SAMIARSLAN-NKU/EnergyMe-Open-Source-Smart-Energy-Meter/README.md

# EnergyMe-Open-Source-Smart-Energy-Meter
Open-source multi-channel smart energy meter platform based on ESP32-S3 and ADE7953, featuring 17-channel monitoring, circuit-level calibration, REST API, MQTT, InfluxDB, local data logging, and OTA support.
