SAMIARSLAN-NKU/EnergyMe-Open-Source-Smart-Energy-Meter/hardware/images/back.jpg

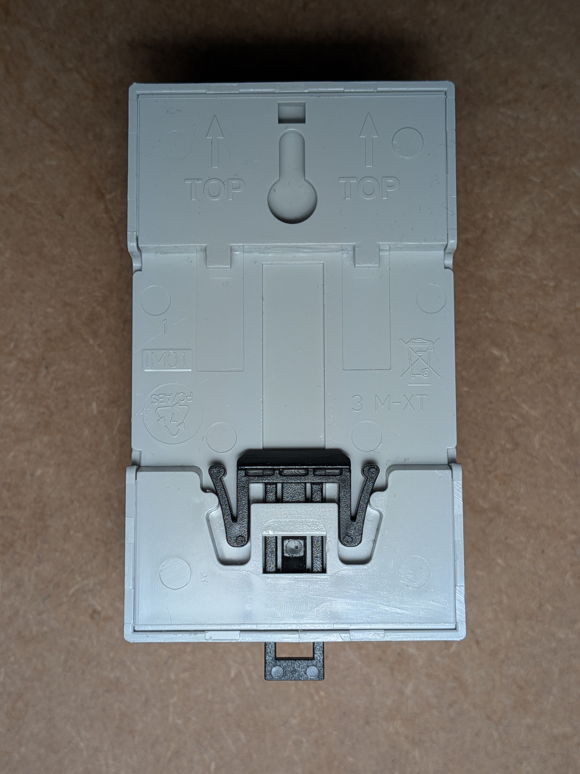
hardware/images/back.jpg
