SAMIARSLAN-NKU/EnergyMe-Open-Source-Smart-Energy-Meter/hardware/images/bottom.jpg

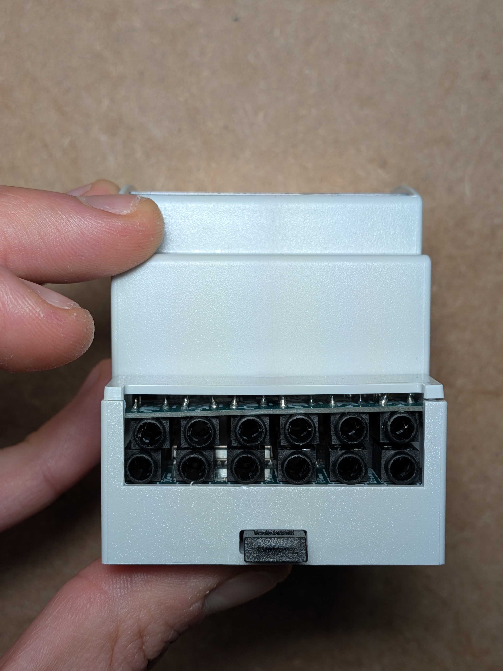
hardware/images/bottom.jpg
