SAMIARSLAN-NKU/EnergyMe-Open-Source-Smart-Energy-Meter/hardware/images/bottom_bare.jpg

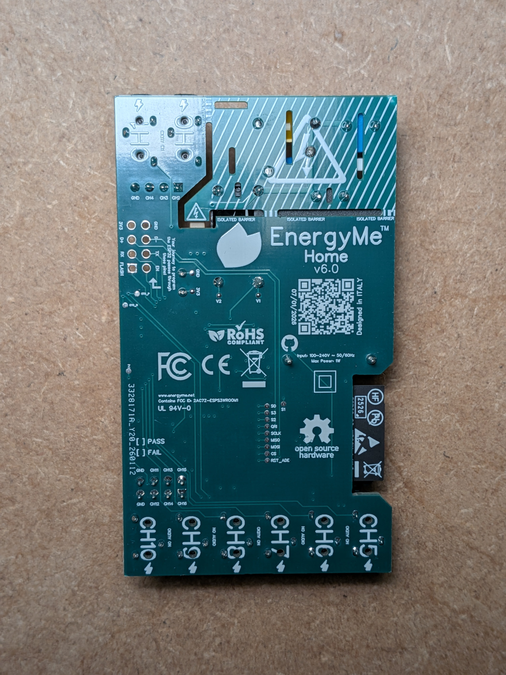
hardware/images/bottom_bare.jpg
