SAMIARSLAN-NKU/EnergyMe-Open-Source-Smart-Energy-Meter/hardware/images/ct.jpg

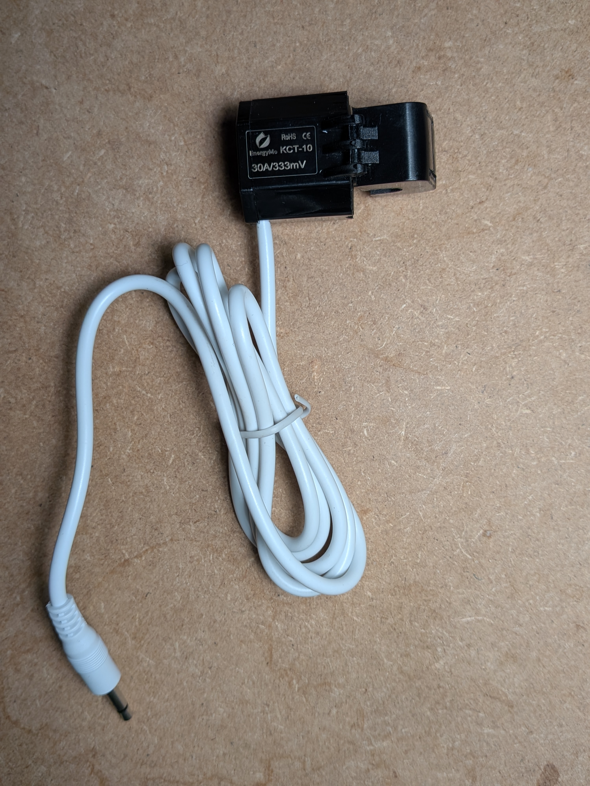
hardware/images/ct.jpg
