SAMIARSLAN-NKU/EnergyMe-Open-Source-Smart-Energy-Meter/hardware/images/front.jpg

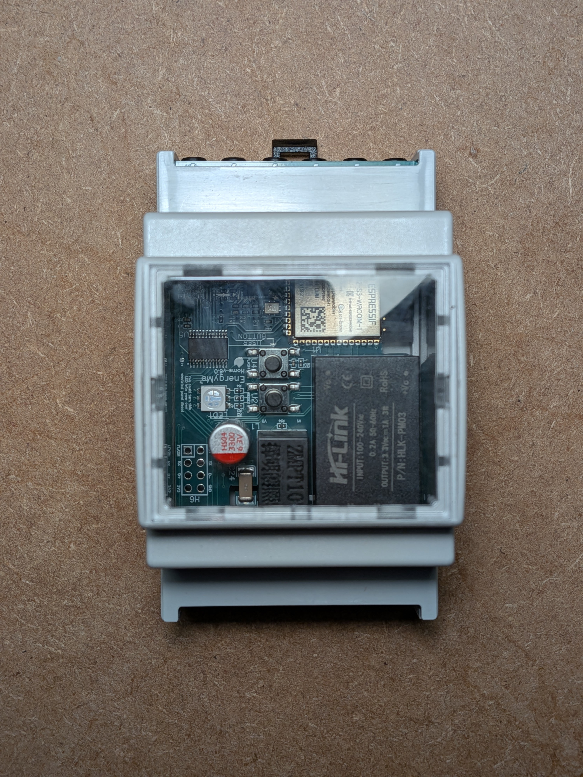
hardware/images/front.jpg
