SAMIARSLAN-NKU/EnergyMe-Open-Source-Smart-Energy-Meter/hardware/images/top_bare.jpg

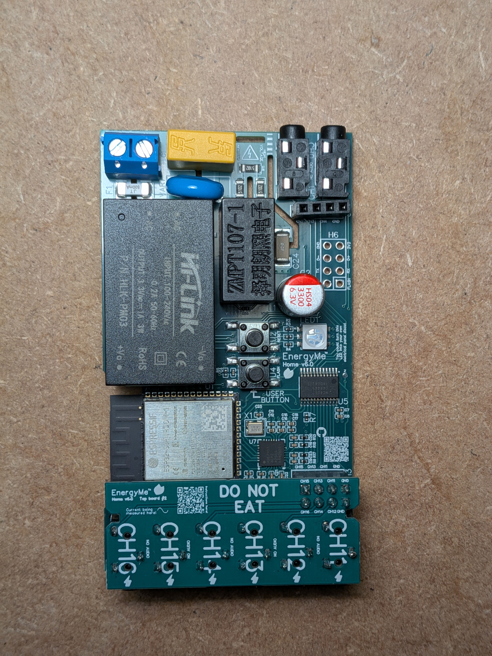
hardware/images/top_bare.jpg
