SAMIARSLAN-NKU/EnergyMe-Open-Source-Smart-Energy-Meter/hardware/images/top_with_ct.jpg

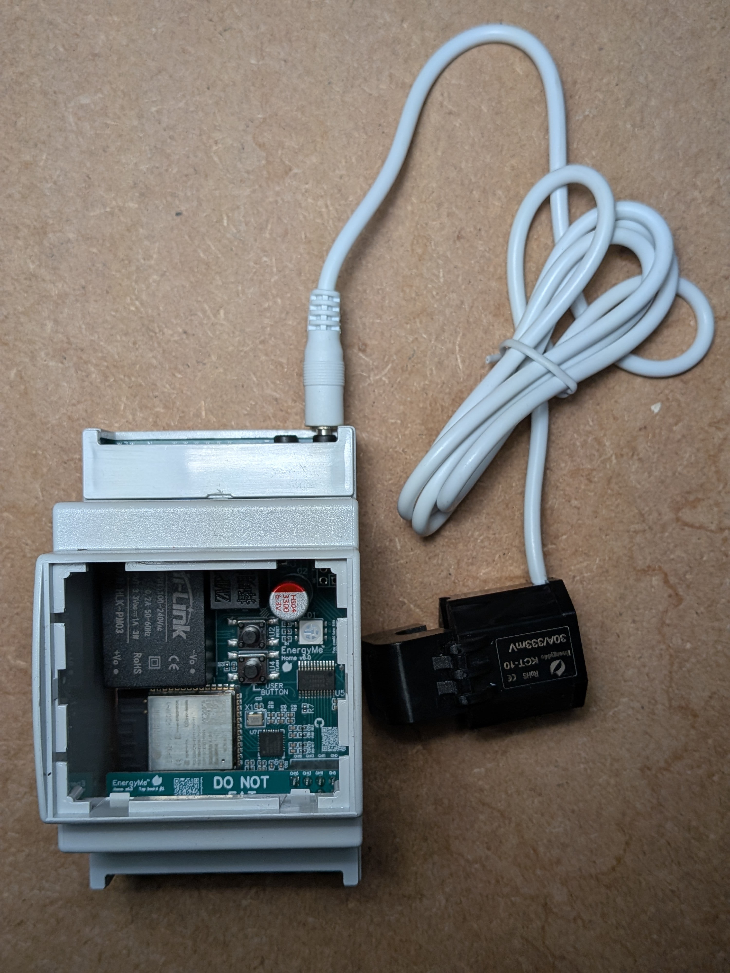
hardware/images/top_with_ct.jpg
