SAMIARSLAN-NKU/EnergyMe-Open-Source-Smart-Energy-Meter/hardware/pcb/main_board/3d_view_top.png

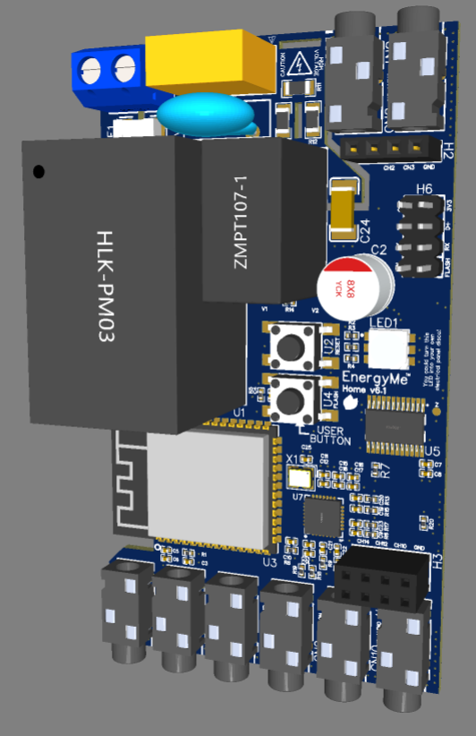
hardware/pcb/main_board/3d_view_top.png
