SAMIARSLAN-NKU/EnergyMe-Open-Source-Smart-Energy-Meter/hardware/pcb/main_board/pcb_bottom.png

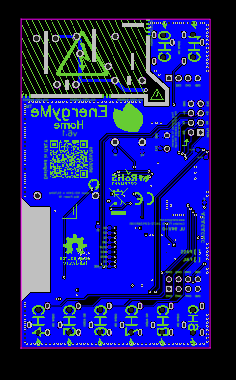
hardware/pcb/main_board/pcb_bottom.png
