SAMIARSLAN-NKU/EnergyMe-Open-Source-Smart-Energy-Meter/hardware/pcb/main_board/pcb_top.png

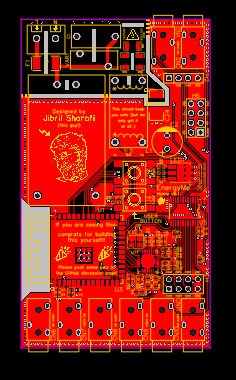
hardware/pcb/main_board/pcb_top.png
