SAMIARSLAN-NKU/EnergyMe-Open-Source-Smart-Energy-Meter/hardware/pcb/schematics_page_2.png

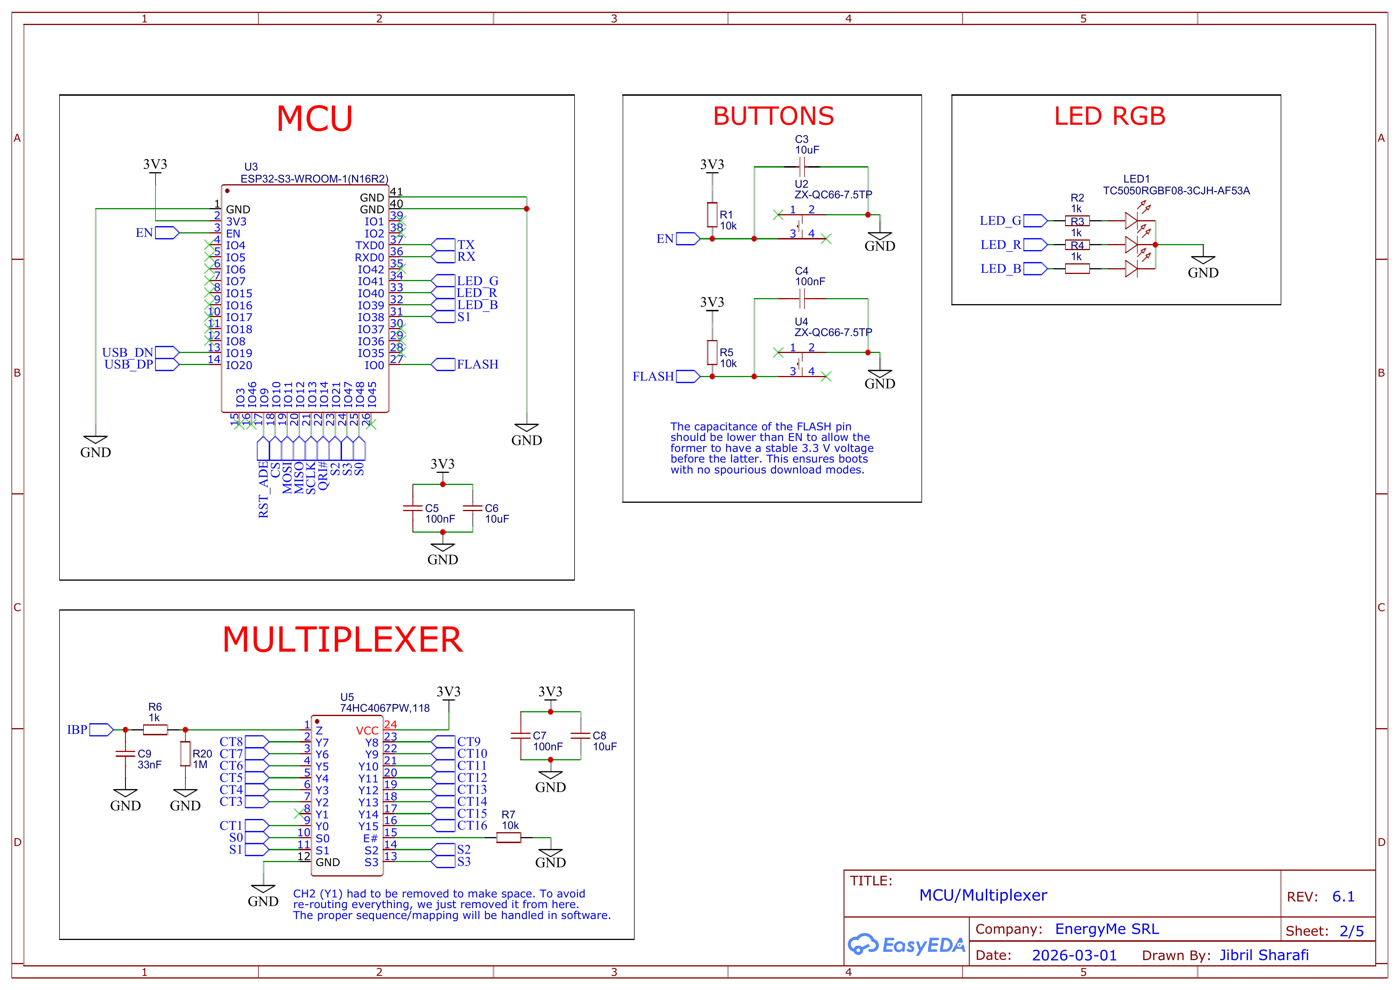
hardware/pcb/schematics_page_2.png
