SAMIARSLAN-NKU/EnergyMe-Open-Source-Smart-Energy-Meter/hardware/pcb/schematics_page_5.png

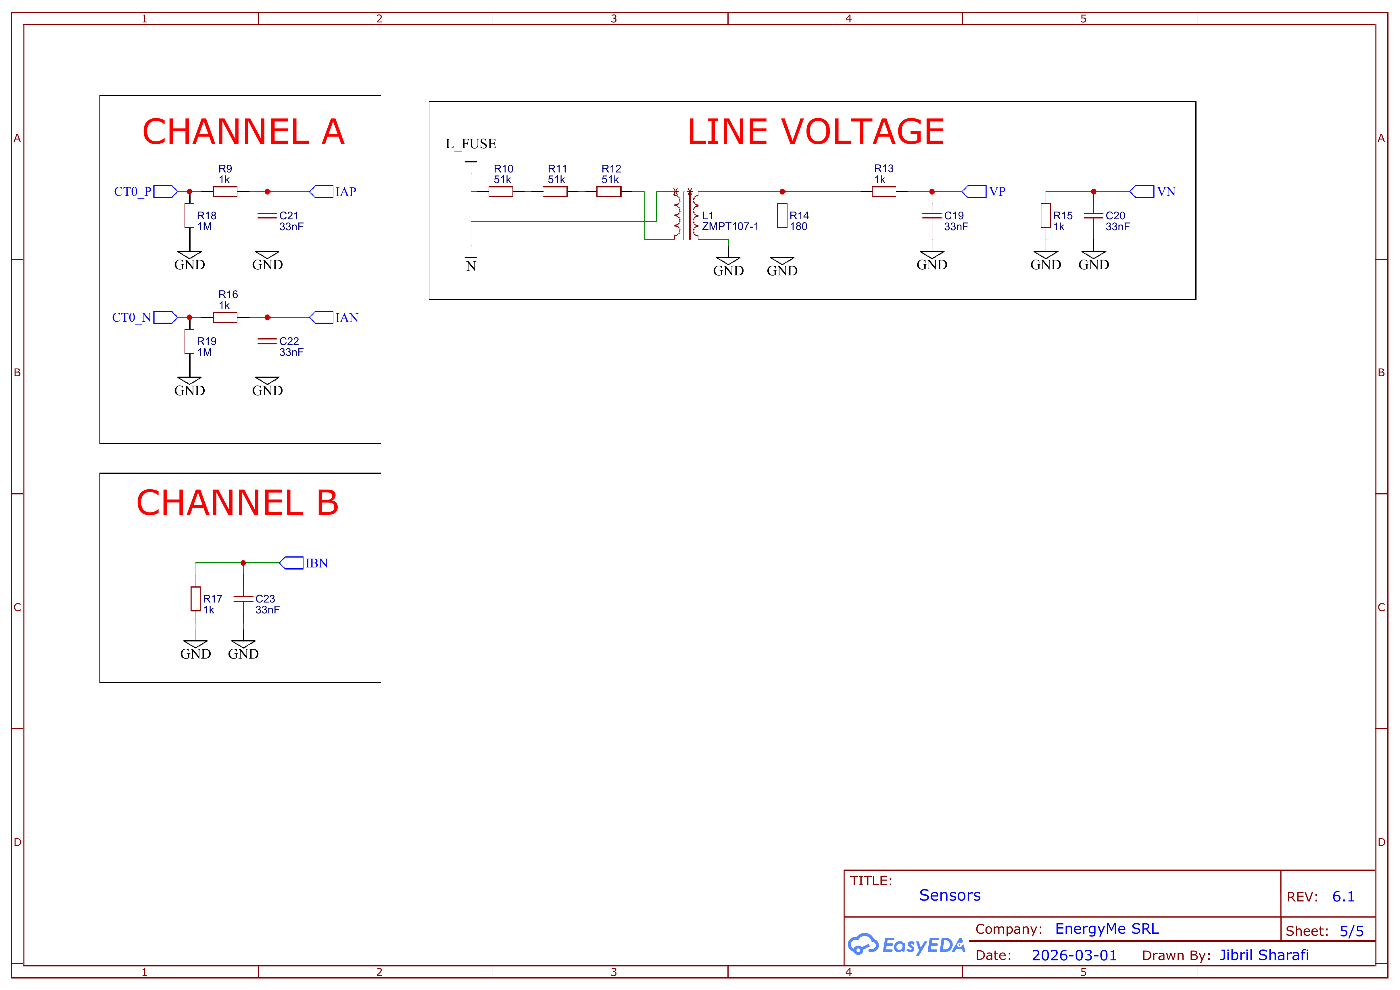
hardware/pcb/schematics_page_5.png
