SAMIARSLAN-NKU/EnergyMe-Open-Source-Smart-Energy-Meter/hardware/pcb/top_board_1/3d_view_bottom.png

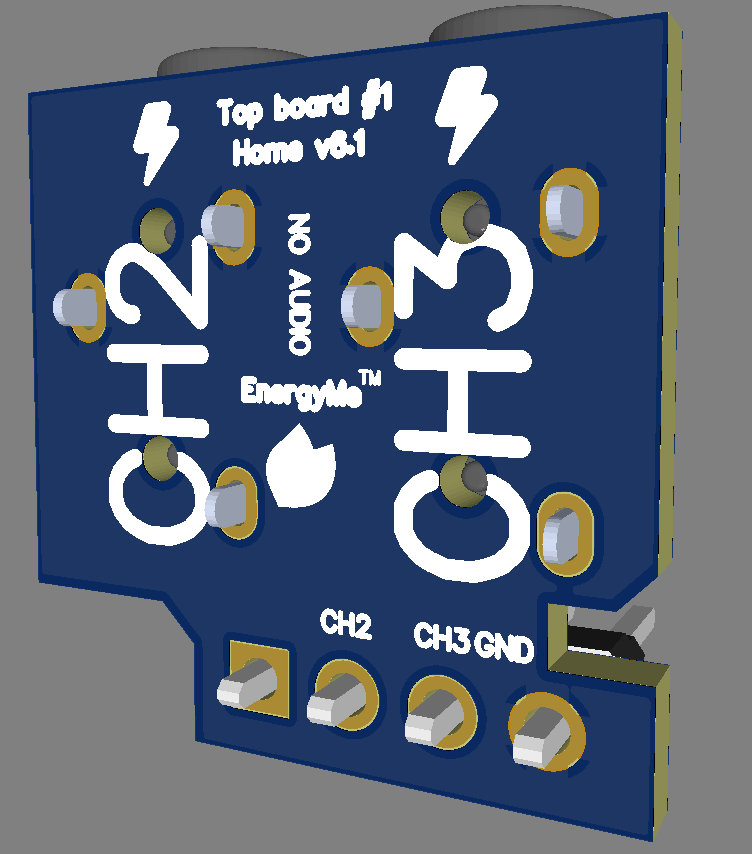
hardware/pcb/top_board_1/3d_view_bottom.png
