SAMIARSLAN-NKU/EnergyMe-Open-Source-Smart-Energy-Meter/hardware/pcb/top_board_1/3d_view_top.png

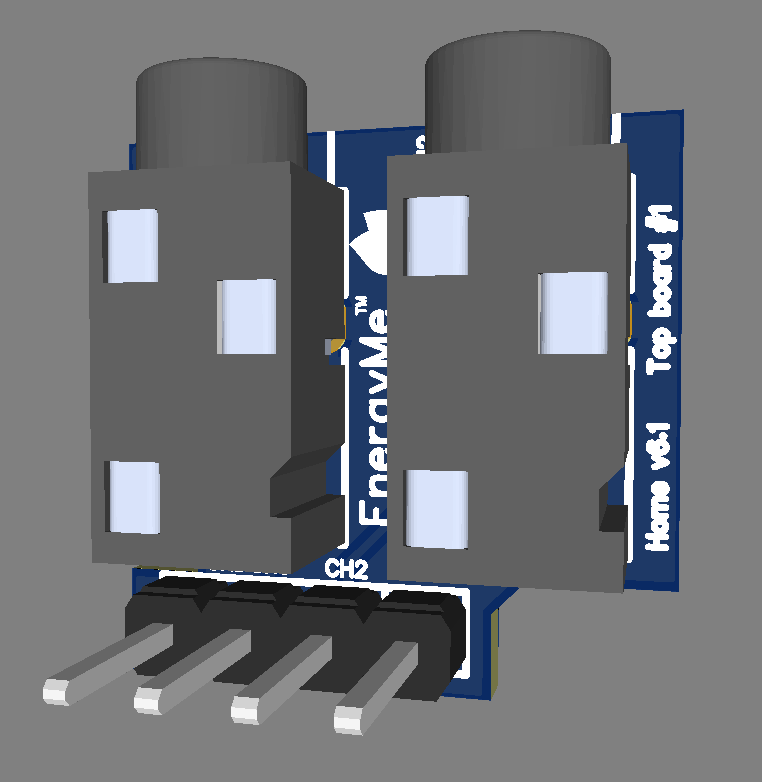
hardware/pcb/top_board_1/3d_view_top.png
