SAMIARSLAN-NKU/EnergyMe-Open-Source-Smart-Energy-Meter/hardware/pcb/top_board_2/3d_view_bottom.png

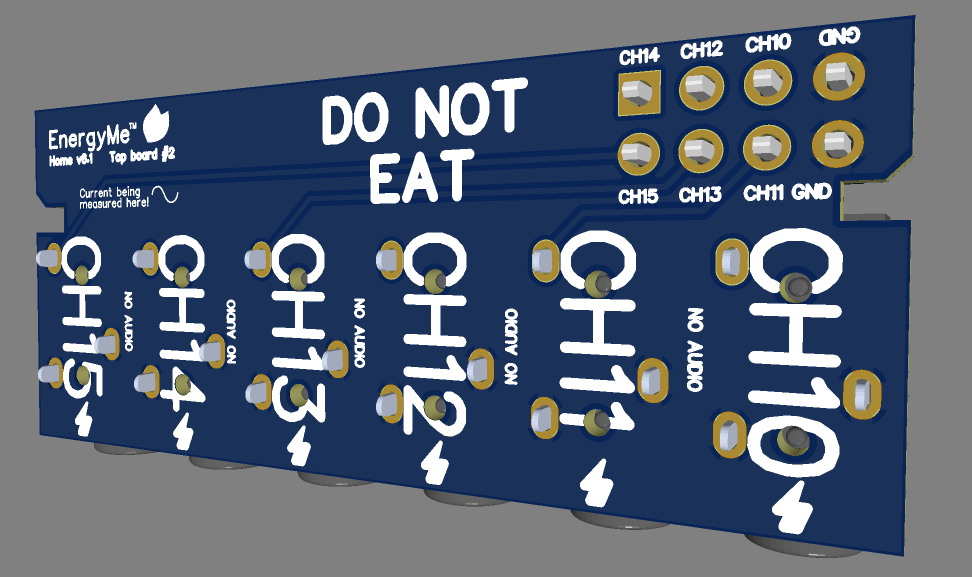
hardware/pcb/top_board_2/3d_view_bottom.png
