SAMIARSLAN-NKU/EnergyMe-Open-Source-Smart-Energy-Meter/resources/3D model horizontal.png

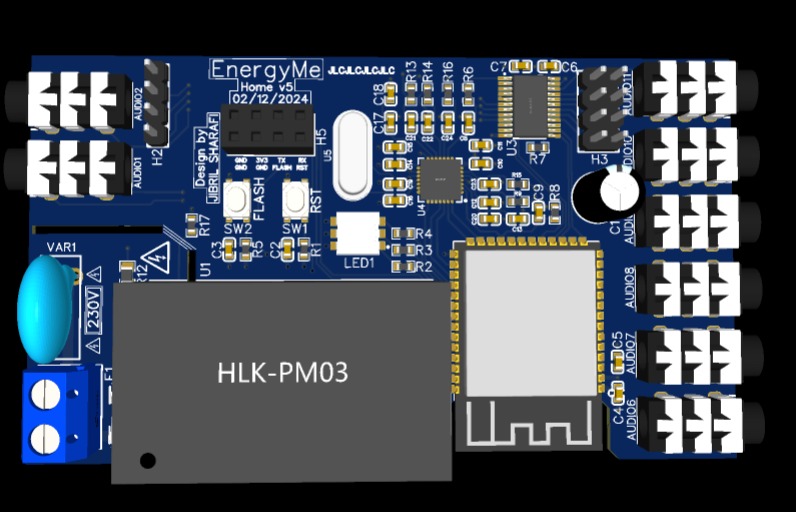
resources/3D model horizontal.png
