SAMIARSLAN-NKU/EnergyMe-Open-Source-Smart-Energy-Meter/resources/3D model.png

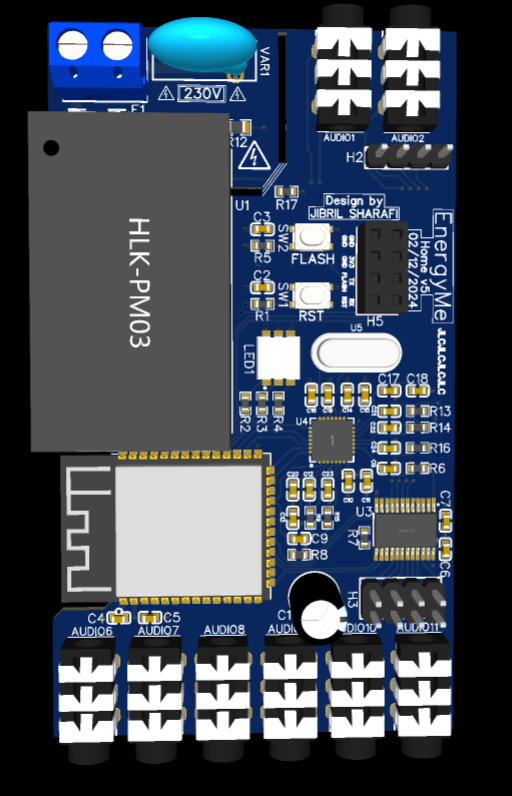
resources/3D model.png
