SAMIARSLAN-NKU/EnergyMe-Open-Source-Smart-Energy-Meter/resources/app.png

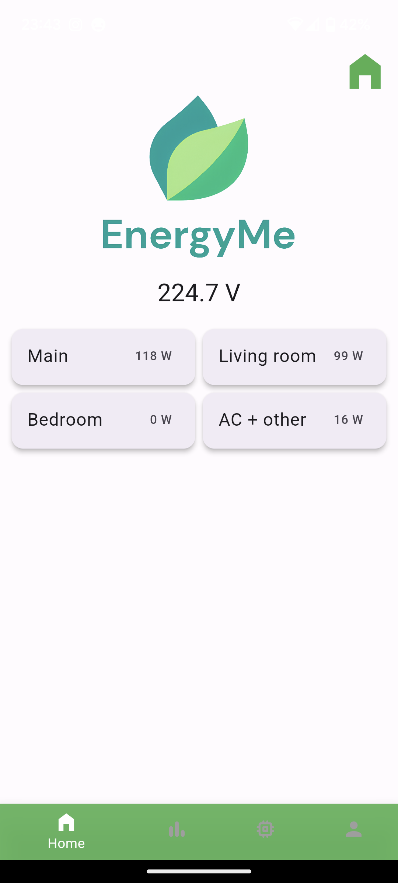
resources/app.png
