SAMIARSLAN-NKU/EnergyMe-Open-Source-Smart-Energy-Meter/resources/architecture.png

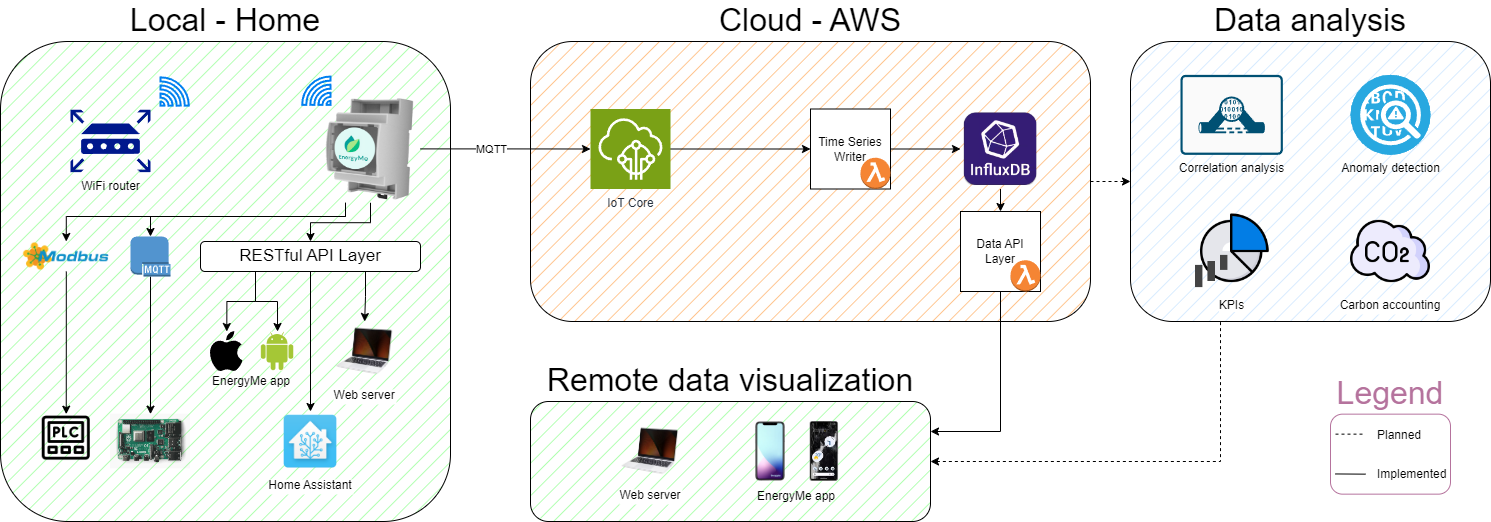
resources/architecture.png
