SAMIARSLAN-NKU/EnergyMe-Open-Source-Smart-Energy-Meter/resources/back_pcb_populated.jpg

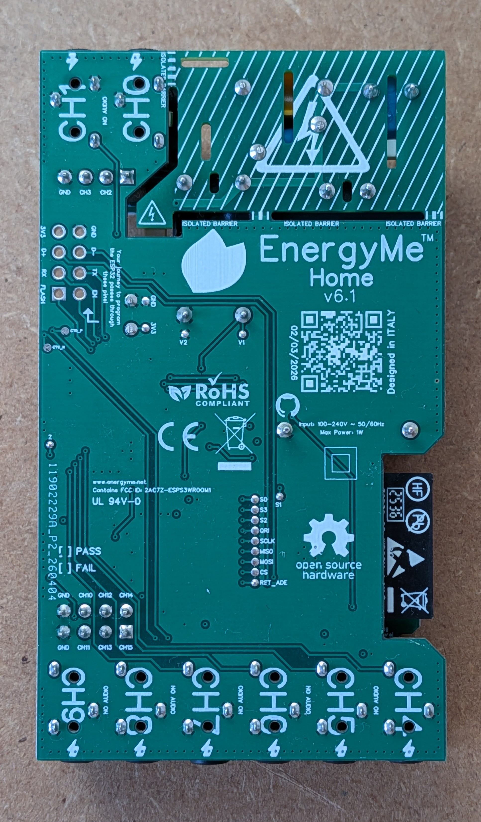
resources/back_pcb_populated.jpg
