SAMIARSLAN-NKU/EnergyMe-Open-Source-Smart-Energy-Meter/resources/Bare PCB.jpg

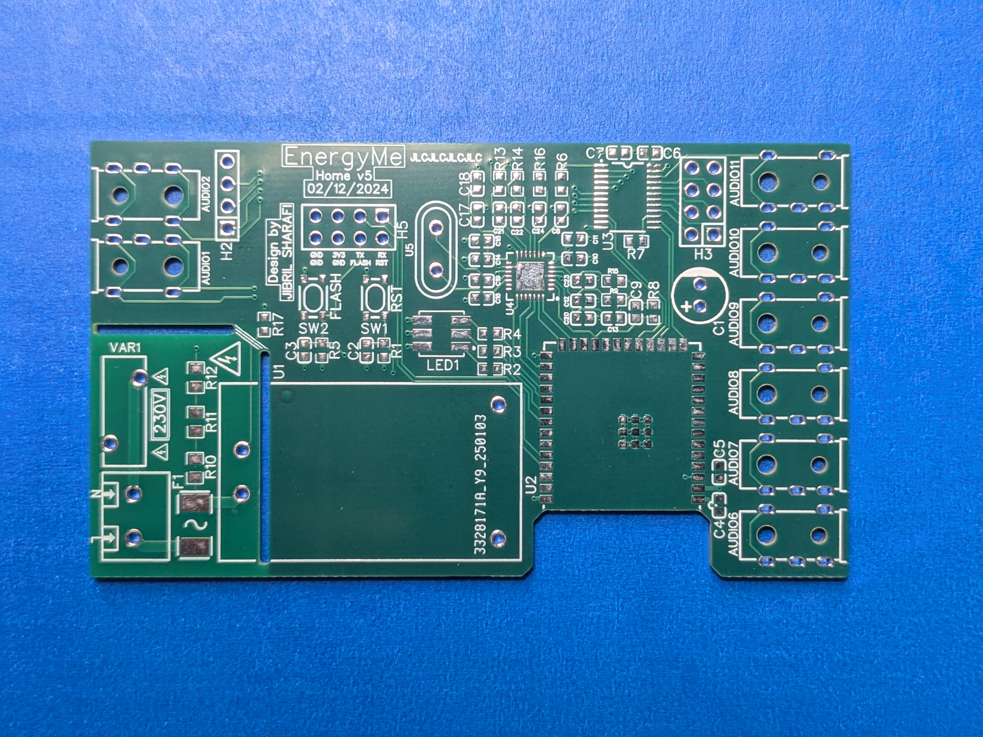
resources/Bare PCB.jpg
