SAMIARSLAN-NKU/EnergyMe-Open-Source-Smart-Energy-Meter/resources/case.jpg

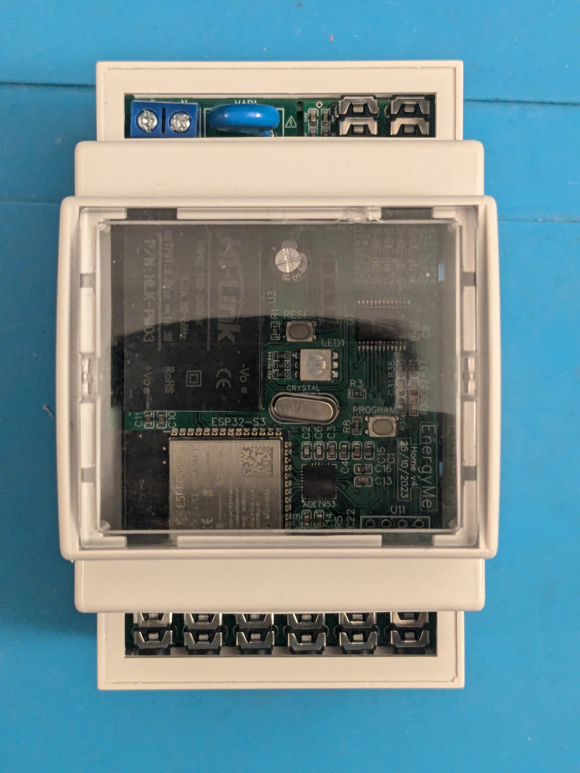
resources/case.jpg
