SAMIARSLAN-NKU/EnergyMe-Open-Source-Smart-Energy-Meter/resources/certification-mark-IT000025-wide.png

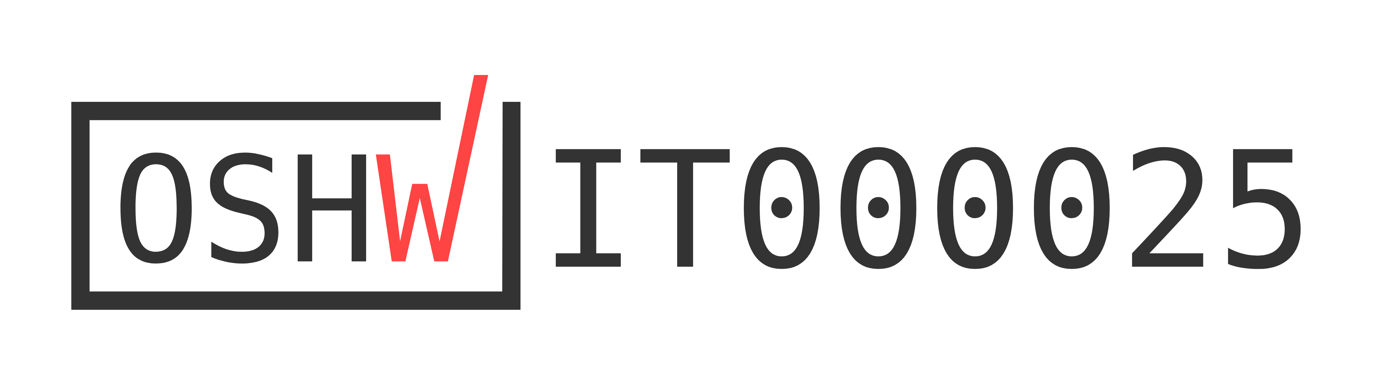
resources/certification-mark-IT000025-wide.png
