SAMIARSLAN-NKU/EnergyMe-Open-Source-Smart-Energy-Meter/resources/front_pcb_populated.jpg

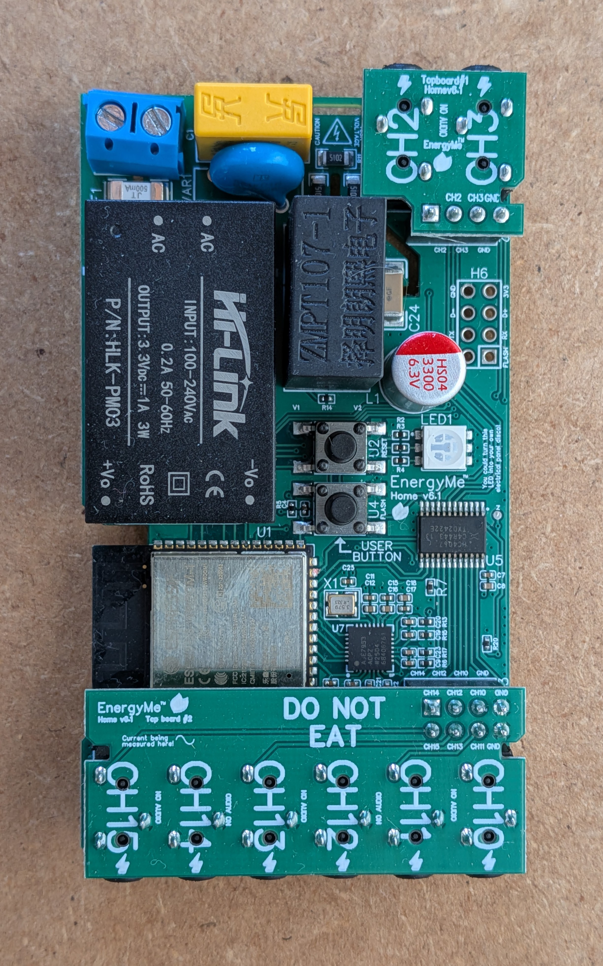
resources/front_pcb_populated.jpg
