SAMIARSLAN-NKU/EnergyMe-Open-Source-Smart-Energy-Meter/resources/homeassistant_energy_panel.png

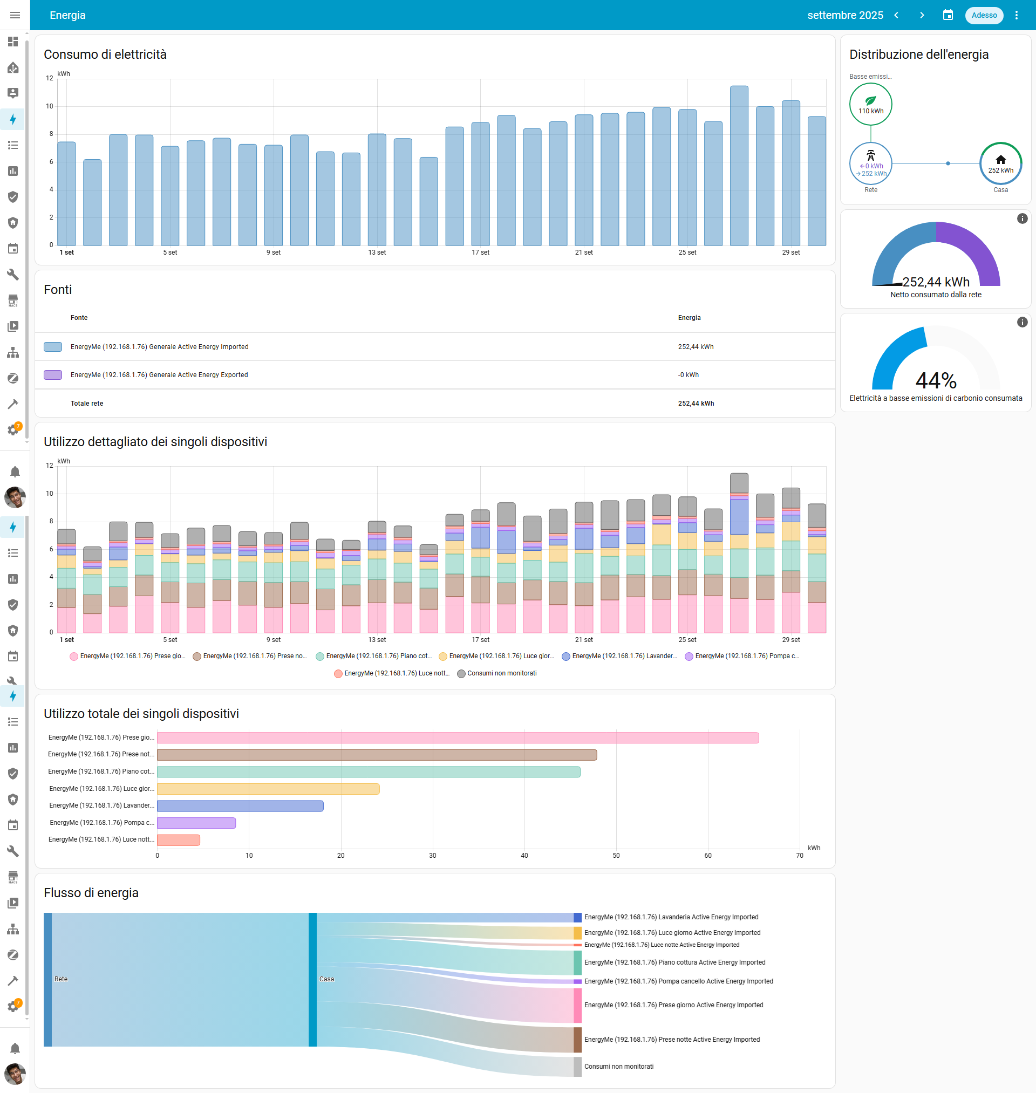
resources/homeassistant_energy_panel.png
