SAMIARSLAN-NKU/EnergyMe-Open-Source-Smart-Energy-Meter/resources/homeassistant_integration.png

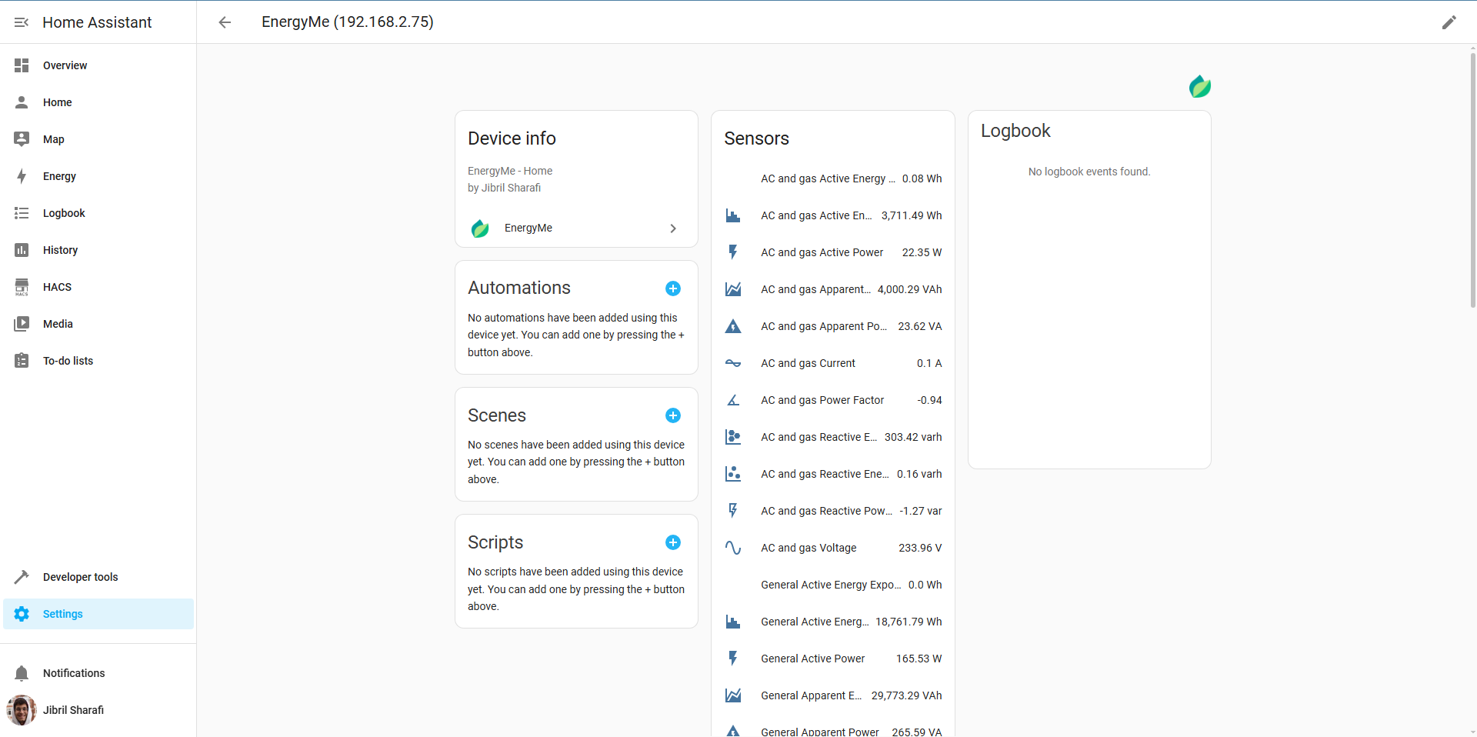
resources/homeassistant_integration.png
