SAMIARSLAN-NKU/EnergyMe-Open-Source-Smart-Energy-Meter/resources/homepage.gif

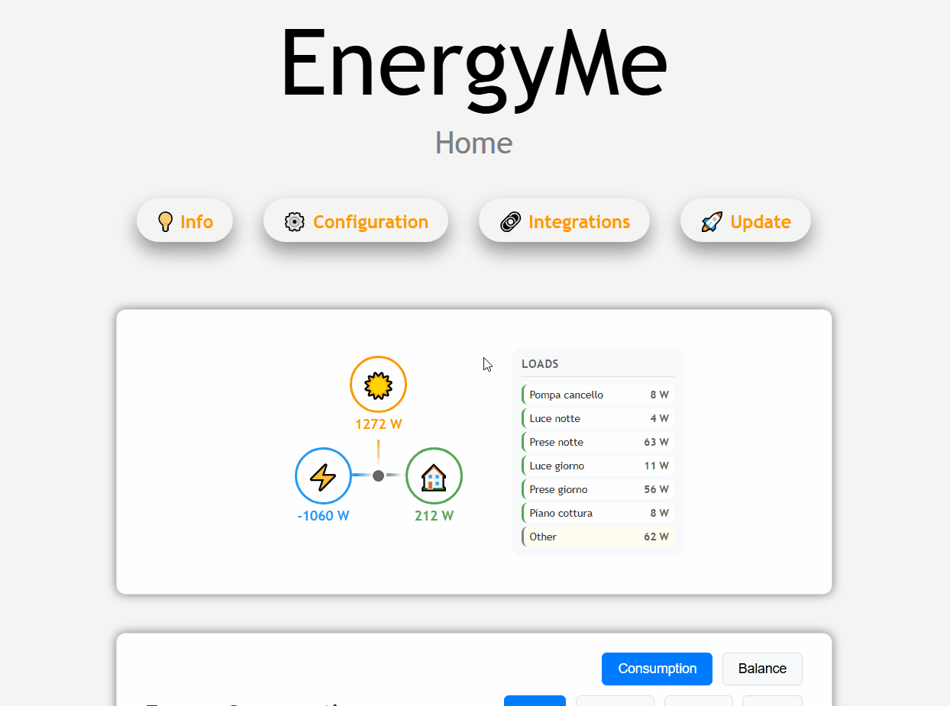
resources/homepage.gif
