SAMIARSLAN-NKU/EnergyMe-Open-Source-Smart-Energy-Meter/resources/influxdb.png

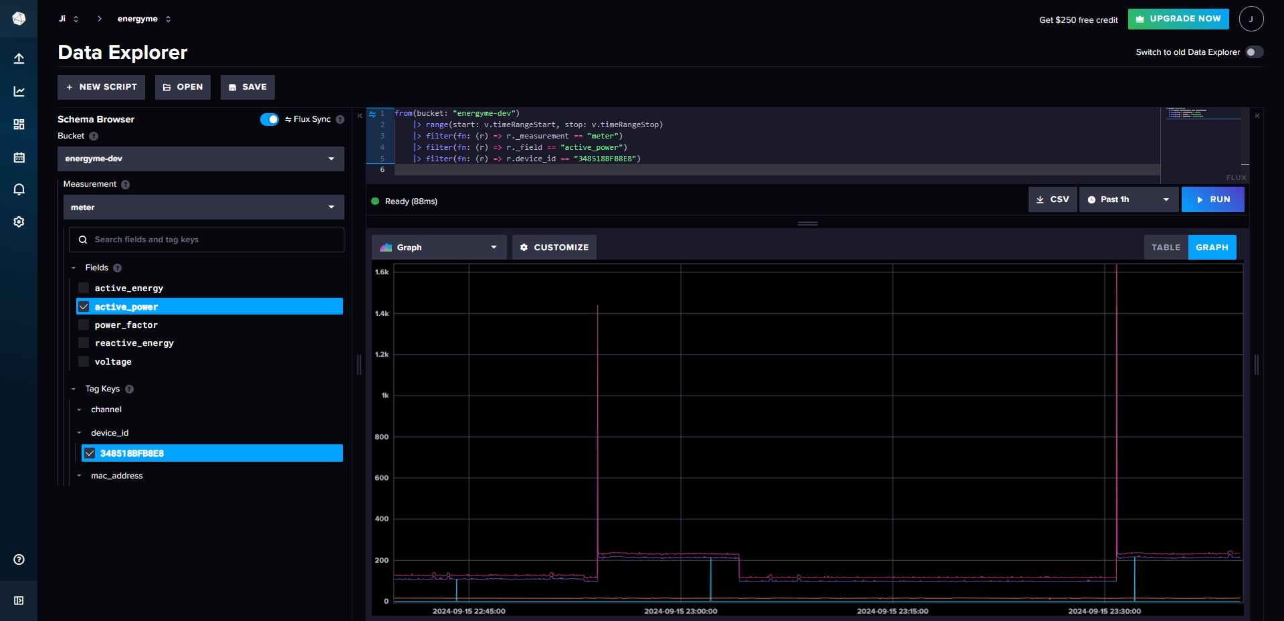
resources/influxdb.png
