SAMIARSLAN-NKU/EnergyMe-Open-Source-Smart-Energy-Meter/resources/PCB angle view 1.jpg

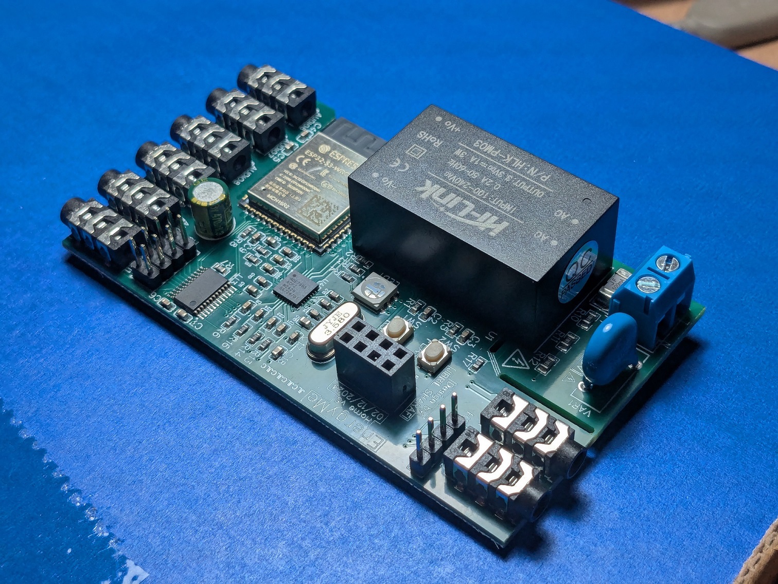
resources/PCB angle view 1.jpg
