SAMIARSLAN-NKU/EnergyMe-Open-Source-Smart-Energy-Meter/resources/PCB angle view 2.jpg

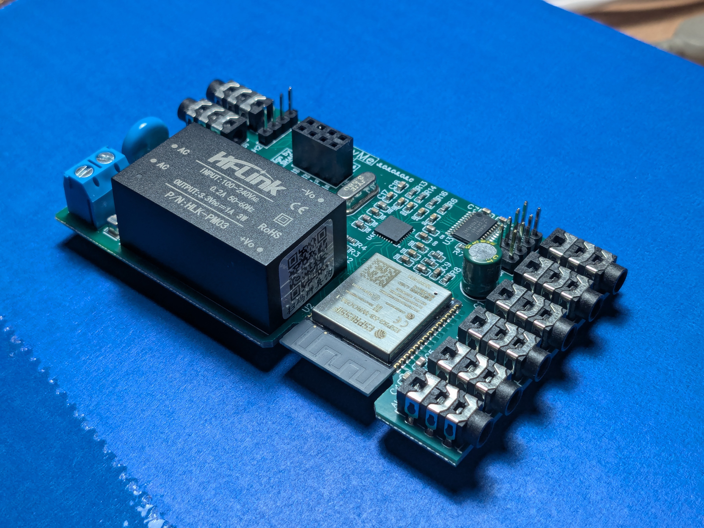
resources/PCB angle view 2.jpg
