SAMIARSLAN-NKU/EnergyMe-Open-Source-Smart-Energy-Meter/resources/PCB top view.jpg

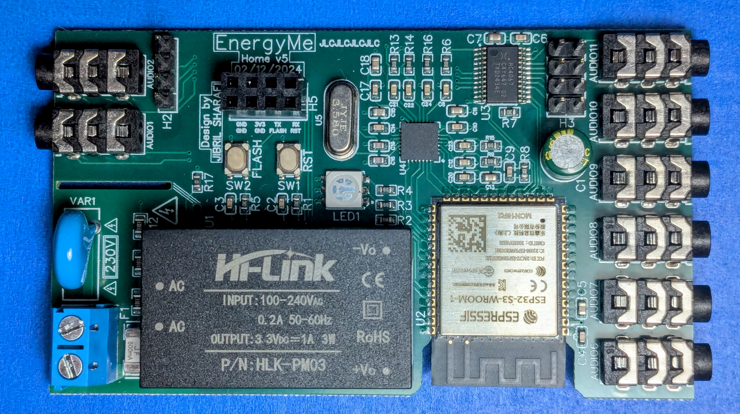
resources/PCB top view.jpg
