SAMIARSLAN-NKU/EnergyMe-Open-Source-Smart-Energy-Meter/resources/swagger.png

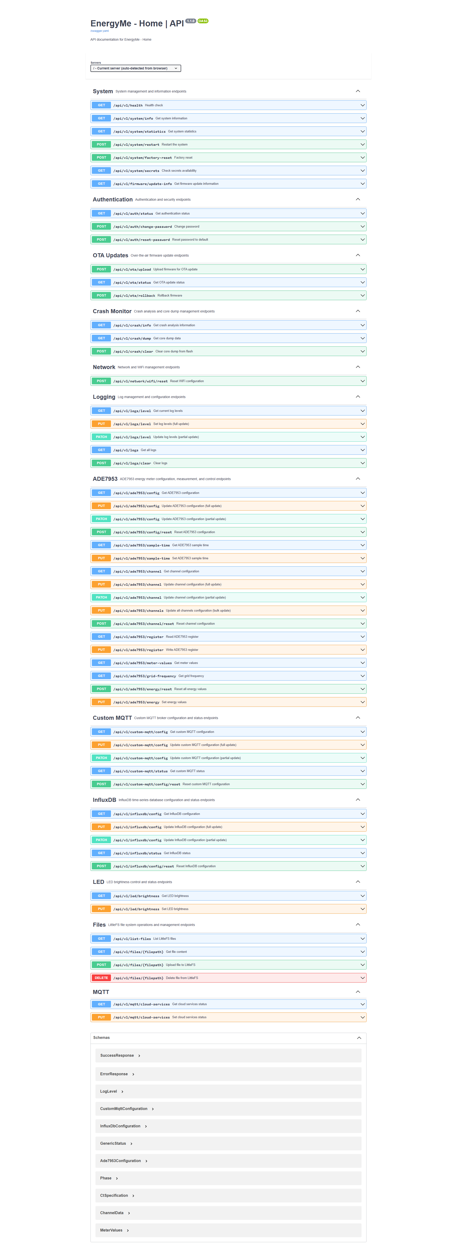
resources/swagger.png
