SAMIARSLAN-NKU/EnergyMe-Open-Source-Smart-Energy-Meter/resources/waveform.png

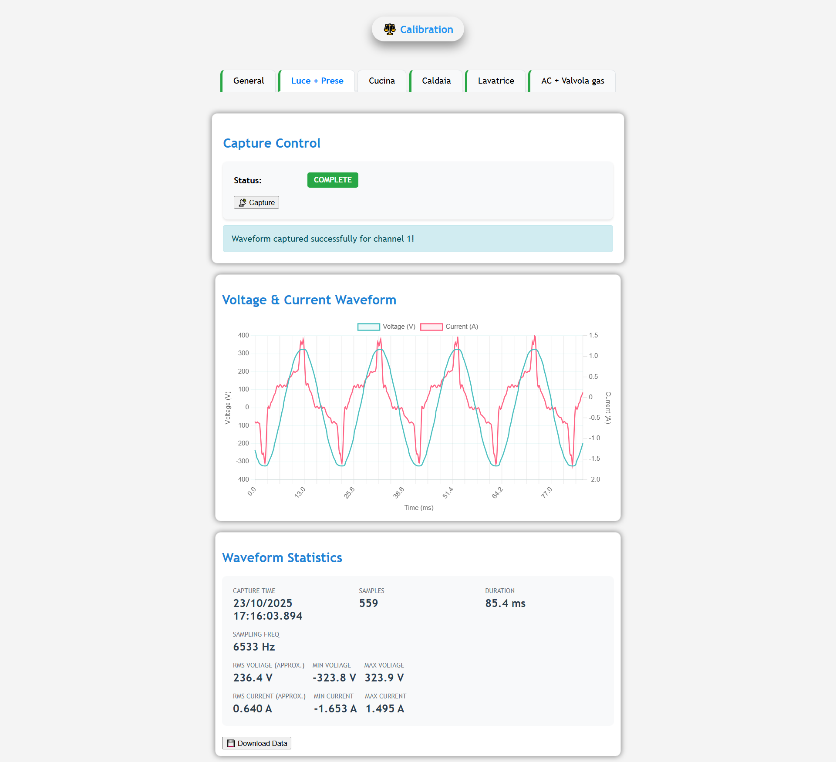
resources/waveform.png
