SAMIARSLAN-NKU/EnergyMe-Open-Source-Smart-Energy-Meter/hardware/pcb/top_board_1/bom_top_board_1.csv

ID | Name | Designator | Footprint | Quantity | Manufacturer Part | Manufacturer | Supplier | Supplier Part | Price
1 | PJ-3200 | CH2,CH3 | AUDIO-TH_PJ-3200 | 2 | PJ-3200 | XKB Connection(中国星坤) | LCSC | C2689690 | 0.058
2 | PZ254V-11-04P_C2691448 | H1 | HDR-TH_4P-P2.54-V-M | 1 | PZ254V-11-04P | XFCN(兴飞) | LCSC | C2691448 | 0.023
