SAMIARSLAN-NKU/EnergyMe-Open-Source-Smart-Energy-Meter/hardware/pcb/top_board_2/bom_top_board_2.csv

ID | Name | Designator | Footprint | Quantity | Manufacturer Part | Manufacturer | Supplier | Supplier Part | Price
1 | PJ-3200 | CH10,CH11,CH12,CH13,CH14,CH15 | AUDIO-TH_PJ-3200 | 6 | PJ-3200 | XKB Connection(中国星坤) | LCSC | C2689690 | 0.058
2 | PZ254V-12-8P | H4 | HDR-TH_8P-P2.54-V-M-R2-C4-S2.54 | 1 | PZ254V-12-8P | XFCN(兴飞) | LCSC | C492421 | 0.043
