SAMIARSLAN-NKU/EnergyMe-Open-Source-Smart-Energy-Meter/hardware/pcb/main_board/bom_main_board.csv

ID | Name | Designator | Footprint | Quantity | Manufacturer Part | Manufacturer | Supplier | Supplier Part | Price
1 | PJ-3200 | CN1,CN2,CN6,CN7,CN8,CN9,CN10,CN11 | AUDIO-TH_PJ-3200 | 8 | PJ-3200 | XKB Connection(中国星坤) | LCSC | C2689690 | 0.058
2 | 1MΩ | R18,R19,R20 | R0402 | 3 | 0402WGF1004TCE | UNI-ROYAL(厚声) | LCSC | C26083 | 0.001
3 | 10uF | C3,C6,C8,C12,C14,C16,C18 | C0402 | 7 | CL05A106MQ5NUNC | SAMSUNG(三星) | LCSC | C15525 | 0.006
4 | 100nF | C25,C4,C5,C7,C10,C11,C13,C15,C17 | C0402 | 9 | CC0402KRX7R7BB104 | YAGEO(国巨) | LCSC | C60474 | 0.001
5 | 3300uF | C2 | CAP-TH_BD8.0-P3.50-D0.6-FD | 1 | HS0J338M0816PC | HONOR(荣誉) | LCSC | C5438512 | 0.312
6 | 1nF | C24 | C2211 | 1 | GA352QR7GF102KW01L | muRata(村田) | LCSC | C91599 | 0.262
7 | PM254V-12-08-H85_C2834799 | H3 | HDR-TH_8P-P2.54-V-F-R2-C4-S2.54 | 1 | PM254V-12-08-H85 | XFCN(兴飞) | LCSC | C2834799 | 0.119
8 | JFC2410-0500TS | F1 | F2410 | 1 | JFC2410-0500TS | JDTfuse(集电通) | LCSC | C136377 | 0.081
9 | ZMPT107-1 | L1 | XFMR-TH_ZMPT107-1 | 1 | ZMPT107-1 | 择明朗熙 | LCSC | C125191 | 0.561
10 | 33nF | C19,C20,C21,C9,C22,C23 | C0402 | 6 | FCC0402B333K500AT | FOJAN(富捷) | LCSC | C7419416 | 0.001
11 | 10kΩ | R8,R1,R5,R7 | R0402 | 4 | 0402WGF1002TCE | UNI-ROYAL(厚声) | LCSC | C25744 | 0.001
12 | 1kΩ | R9,R13,R2,R3,R4,R6,R15,R16,R17 | R0402 | 9 | 0402WGF1001TCE | UNI-ROYAL(厚声) | LCSC | C11702 | 0.001
13 | 51kΩ | R10,R11,R12 | R1206 | 3 | 1206W4F5102T5E | UNI-ROYAL(厚声) | LCSC | C17992 | 0.004
14 | 180Ω | R14 | R0402 | 1 | 0402WGF1800TCE | UNI-ROYAL(厚声) | LCSC | C38941 | 0.001
15 | PM254V-11-04-H85 | H2 | HDR-TH_4P-P2.54-V-F | 1 | PM254V-11-04-H85 | XFCN(兴飞) | LCSC | C541851 | 0.063
16 | 3.579545MHz | X1 | OSC-SMD_4P-L3.2-W2.5-BL_FT3HNBPK16.0-T1 | 1 | RO03579043 | TROQ(创捷) | LCSC | C7206319 | 0.264
17 | ESP32-S3-WROOM-1(N16R2) | U3 | WIRELM-SMD_ESP32-S3-WROOM-1 | 1 | ESP32-S3-WROOM-1-N16R2 | ESPRESSIF(乐鑫) | LCSC | C2913205 | 4.802
18 | 74HC4067PW,118 | U5 | TSSOP-24_L7.8-W4.4-P0.65-LS6.4-BL | 1 | 74HC4067PW,118 | Nexperia(安世) | LCSC | C179326 | 0.573
19 | ADE7953ACPZ-RL | U7 | LFCSP-28_L5.0-W5.0-P0.50-BL-EP | 1 | ADE7953ACPZ-RL | Analog Devices | LCSC | C515890 | 3.201
20 | 100nF | C1 | CAP-TH_L13.0-W6.0-P10.00-D1.0 | 1 | MP2104K27C3X6LC | SRD(圣融达) | LCSC | C105759 | 0.04
21 | ZX-QC66-7.5TP | U2,U4 | KEY-SMD_4P-L6.0-W6.0-P4.50-LS8.6 | 2 | ZX-QC66-7.5TP | Megastar(兆星) | LCSC | C7470157 | 0.03
22 | TC5050RGBF08-3CJH-AF53A | LED1 | LED-SMD_6P-L5.0-W5.0-TL_TC5050RGBF08 | 1 | TC5050RGBF08-3CJH-AF53A | TCWIN(天成) | LCSC | C784540 | 0.02
23 | HLK-PM03 | U1 | PWRM-TH_HLK-PM03 | 1 | HLK-PM03 | HI-LINK | LCSC | C209904 | 2.67
24 | DB301V-5.0-2P | U6 | CONN-TH_2P-P5.00_L7.6-W10.0 | 1 | DB301V-5.0-2P-BU-S | DIBO(地博电气) | LCSC | C395882 | 0.115
25 | 561KD10 | VAR1 | RES-TH_L12.5-W4.8-P7.50-D1.2-S3.40 | 1 | 561KD10 | Brightking(君耀电子) | LCSC | C78349 | 0.076
