SAMIARSLAN-NKU/EnergyMe-Open-Source-Smart-Energy-Meter/BoardDrawing.dxf

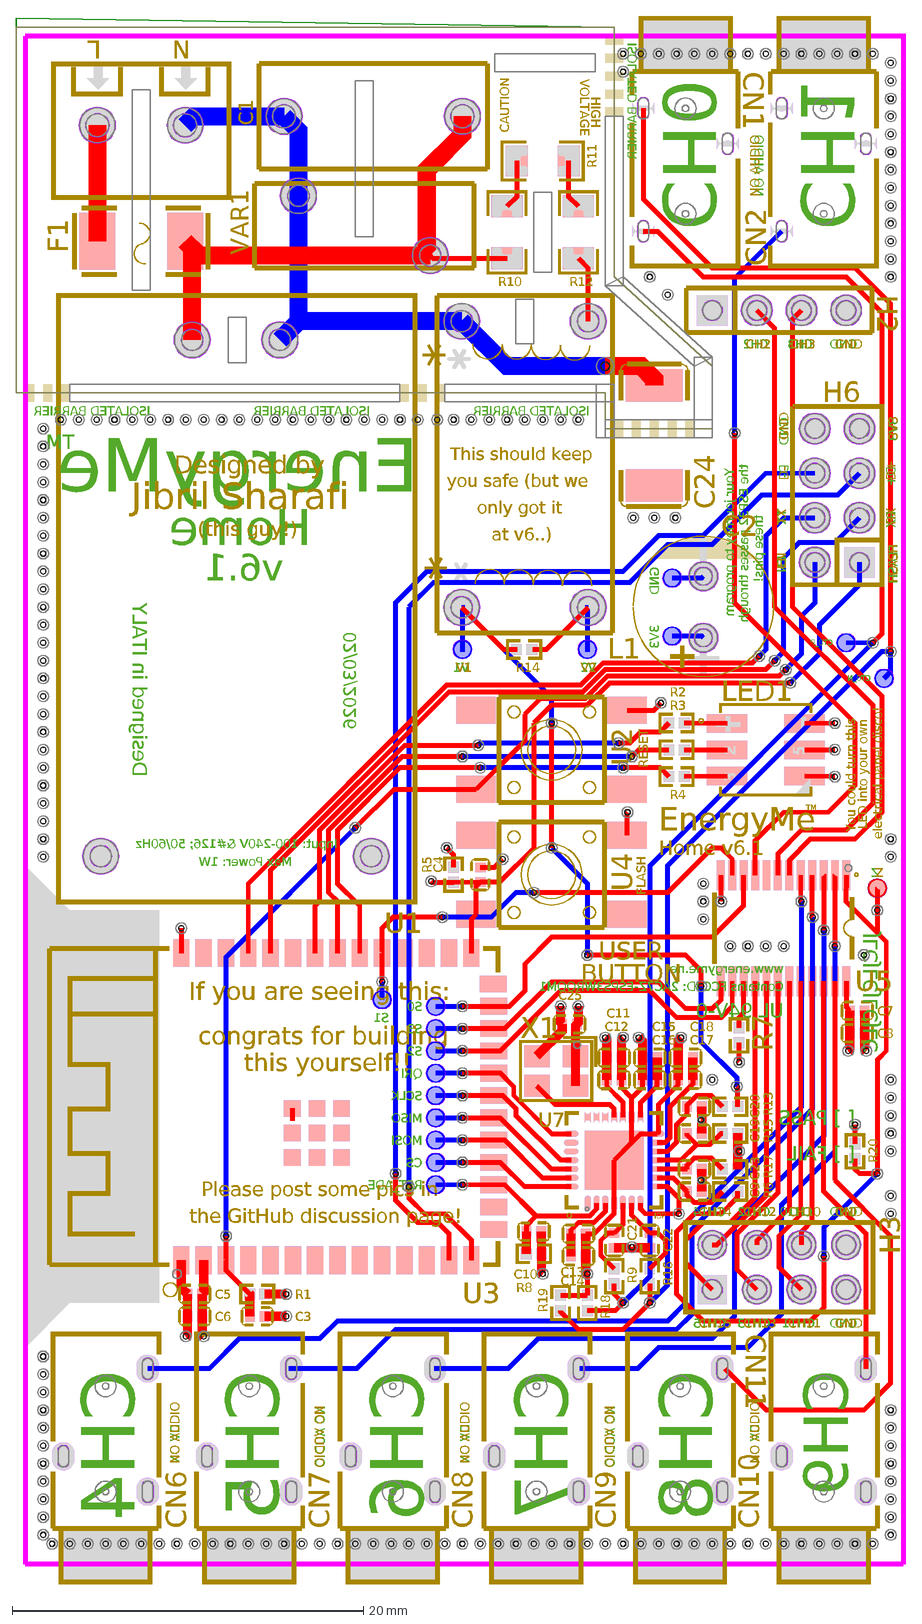
[picture p43: CAD file, 2026-07-04]
BoardDrawing.dxf
Designed in ITALY
RST_ADE
CS
MOSI
MISO
SCLK
QRI
S2
S3
S0
S1
CH0
CH1
CH4
CH5
CH6
CH7
CH8
CH9
FLASH
EN
GND
TX
RX
3V3
CH3
CH2
CH11
CH13
CH15
CH14
CH12
CH10
V1
V2
Z
Input: 100-240V &#126; 50/60Hz
Max Power: 1W
[ ] PASS
[ ] FAIL
Contains FCC ID: 2AC7Z-ESPS3WROOM1
UL 94V-0
JLCJLCJLCJLC
Home
EnergyMe
v6.1
02/03/2026
ISOLATED BARRIER
NO AUDIO
TM
www.energyme.net
CT0_P
CT0_N
D+
D-
these pins!
the ESP32 passes through
Your journey to program
L
N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
