SAMIARSLAN-NKU/EnergyMe-Open-Source-Smart-Energy-Meter/resources/installed_2.jpg

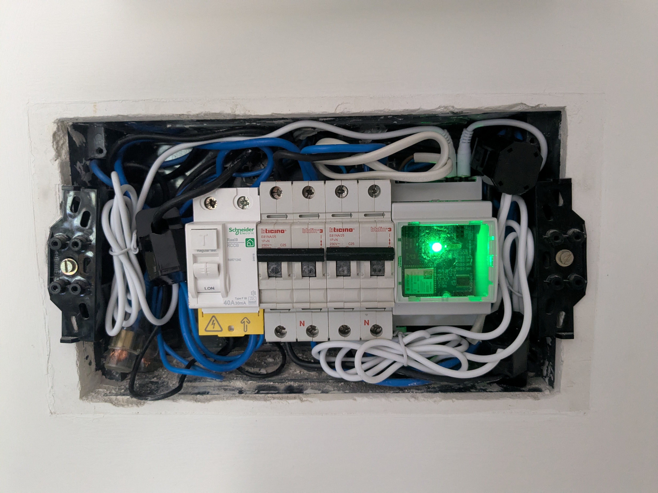
resources/installed_2.jpg
