SAMIARSLAN-NKU/EnergyMe-Open-Source-Smart-Energy-Meter/resources/installed_3.jpg

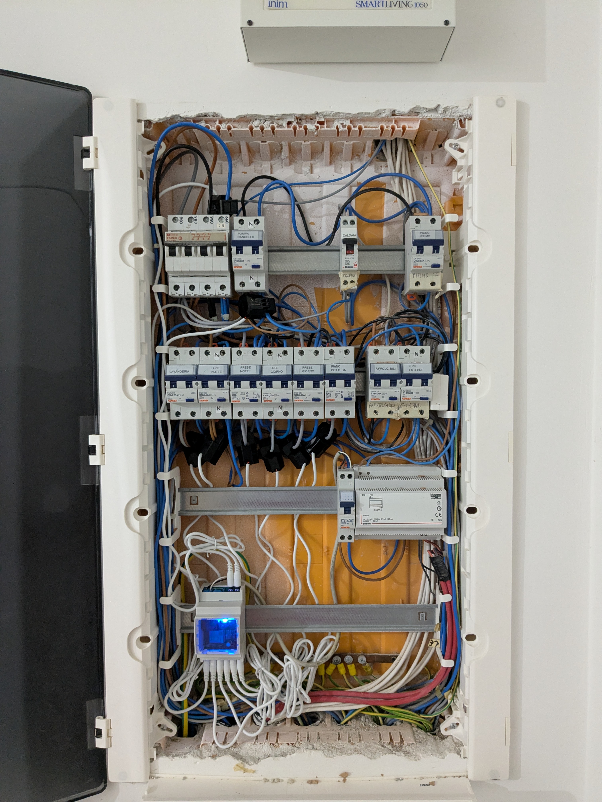
resources/installed_3.jpg
