SAMIARSLAN-NKU/EnergyMe-Open-Source-Smart-Energy-Meter/hardware/pcb/schematics.pdf

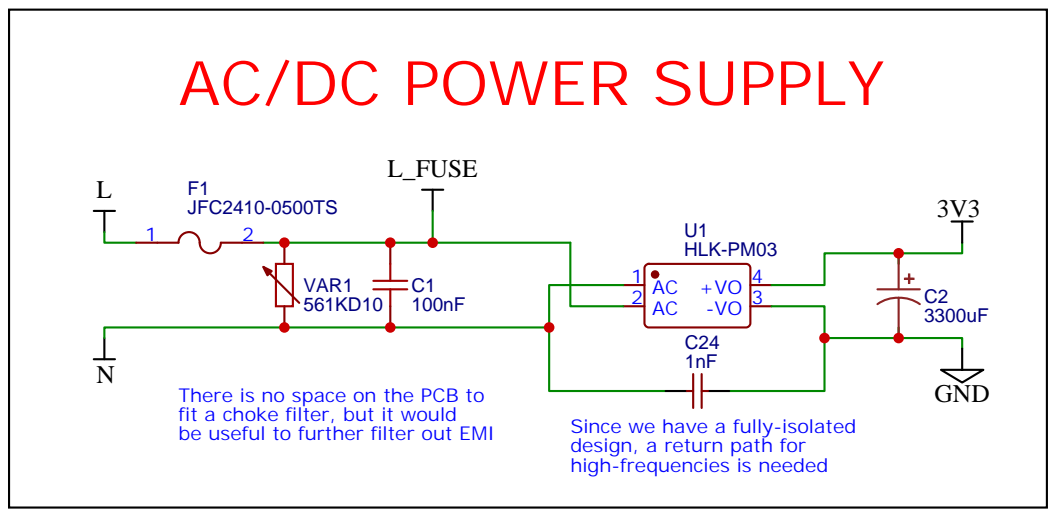
[picture p47: page 1]

AC/DC POWER SUPPLY

There is no space on the PCB to
fit a choke filter, but it would

design, a return path for
high-frequencies is needed

Drawn By: Jibril Sharafi

# MCU

# BUTTONS

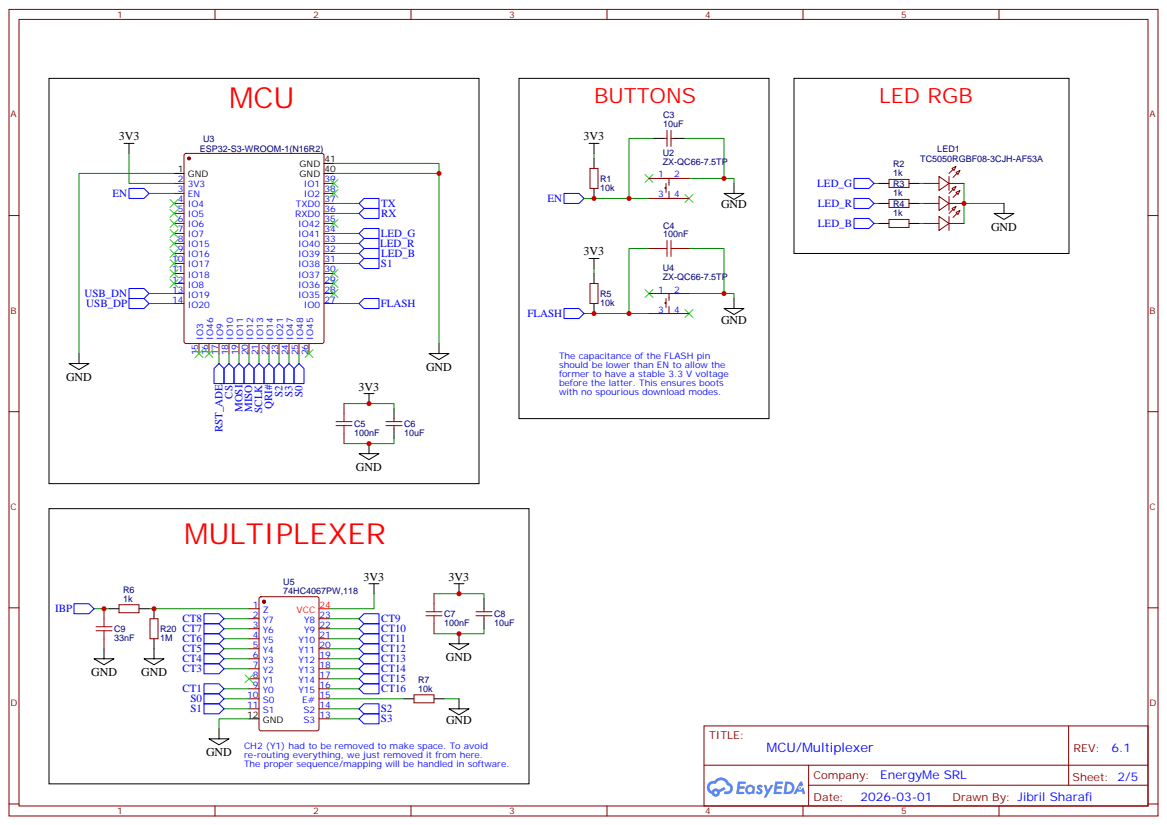
[picture p48: page 2]

IO0 27 IO⁴⁵ 26 IO⁴⁸ 25 IO⁴⁷ 24 IO²¹ 23 IO¹⁴ 22 IO¹³ 21 IO¹² 20 IO¹¹ 19 IO¹⁰ 18 IO⁹ 17 IO⁴⁶ 16 IO³ 15

The capacitance of the FLASH pin
should be lower than EN to allow the
former to have a stable 3.3 V voltage
before the latter. This ensures boots
with no spourious download modes.

CH2 (Y1) had to be removed to make space. To avoid
GND

re-routing everything, we just removed it from here.
The proper sequence/mapping will be handled in software.

TOP BOARD #1 | TOP BOARD #2

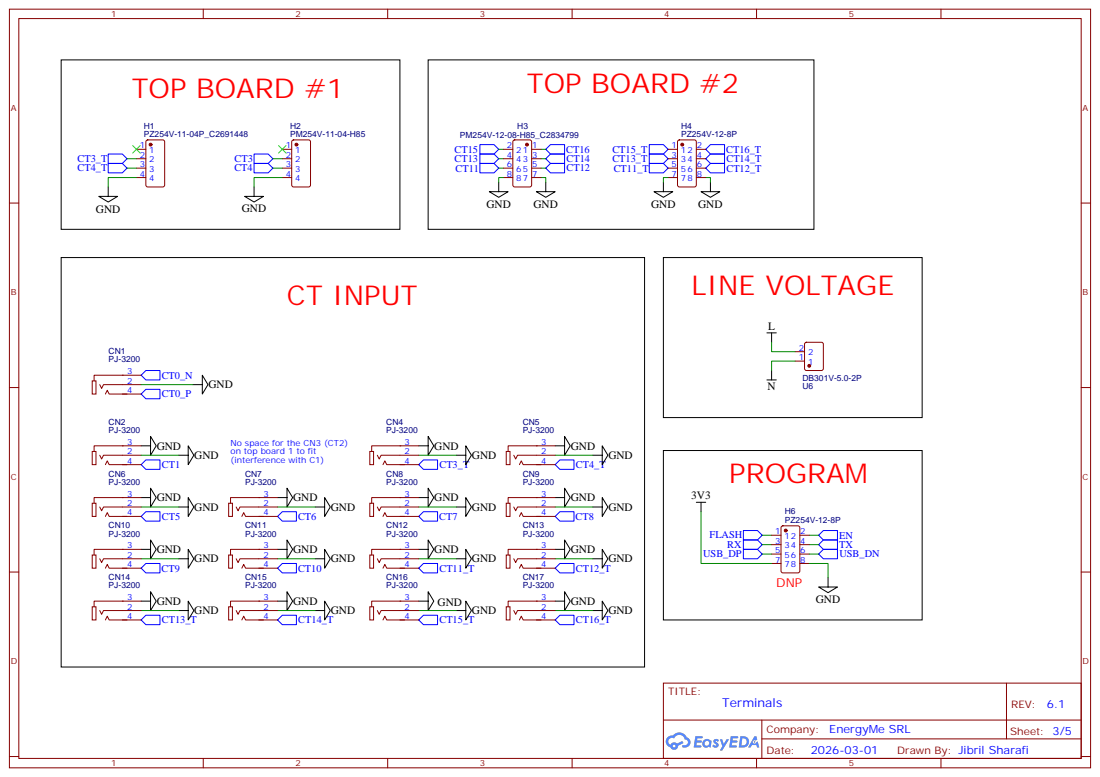
[picture p49: page 3]

No space for the CN3 (CT2)
on top board 1 to fit

# ADE7953

# RESET

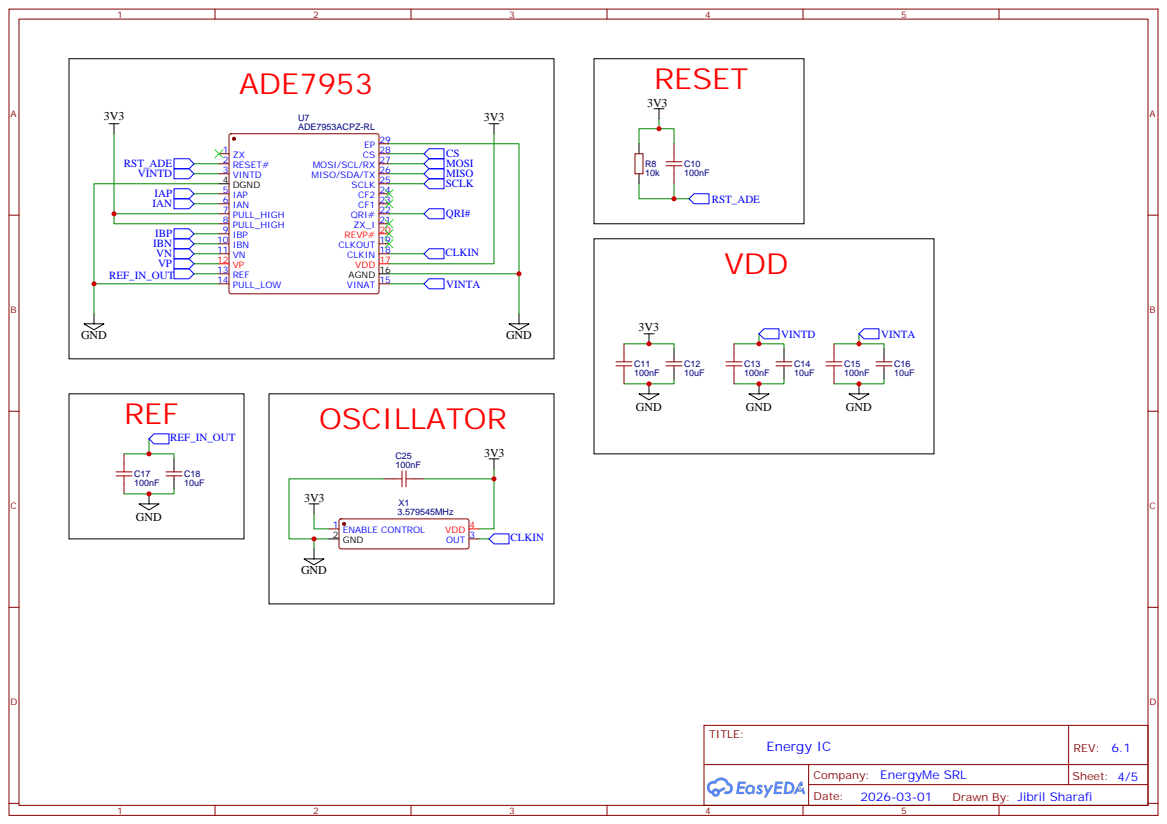
[picture p50: page 4]

# LINE VOLTAGE

# CHANNEL A L_FUSE

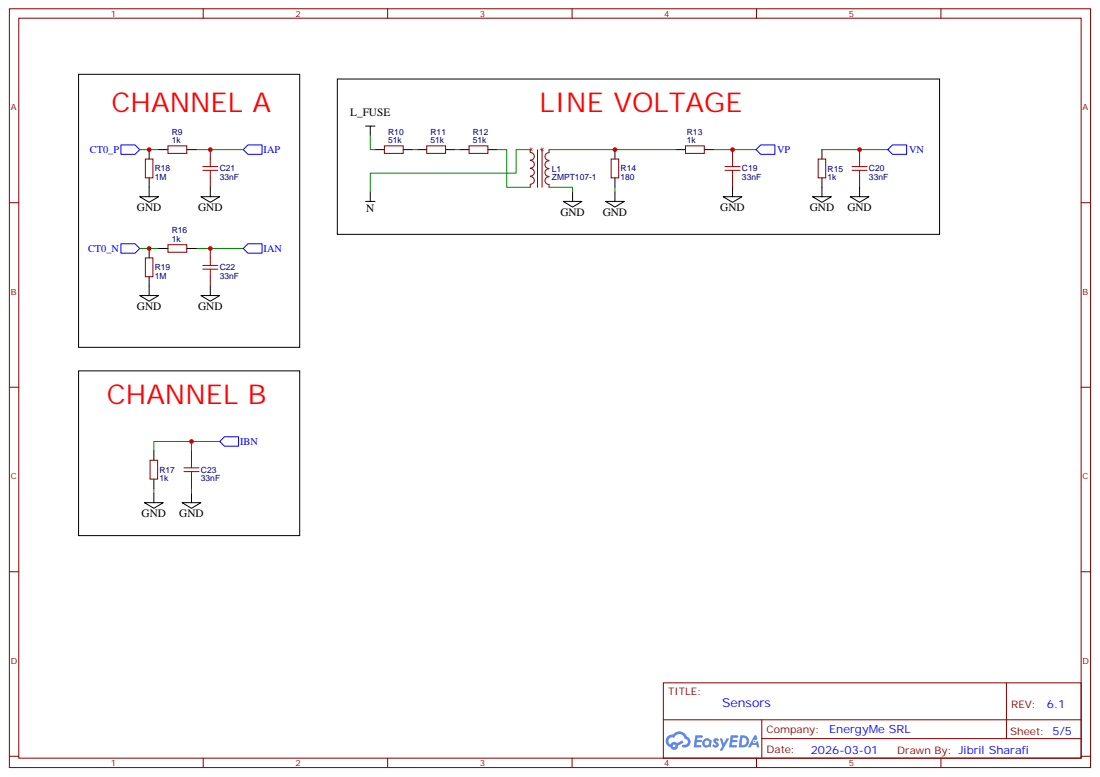
[picture p51: page 5]
