SAMIARSLAN-NKU/EnergyMe-Open-Source-Smart-Energy-Meter/RoughSketch.pdf

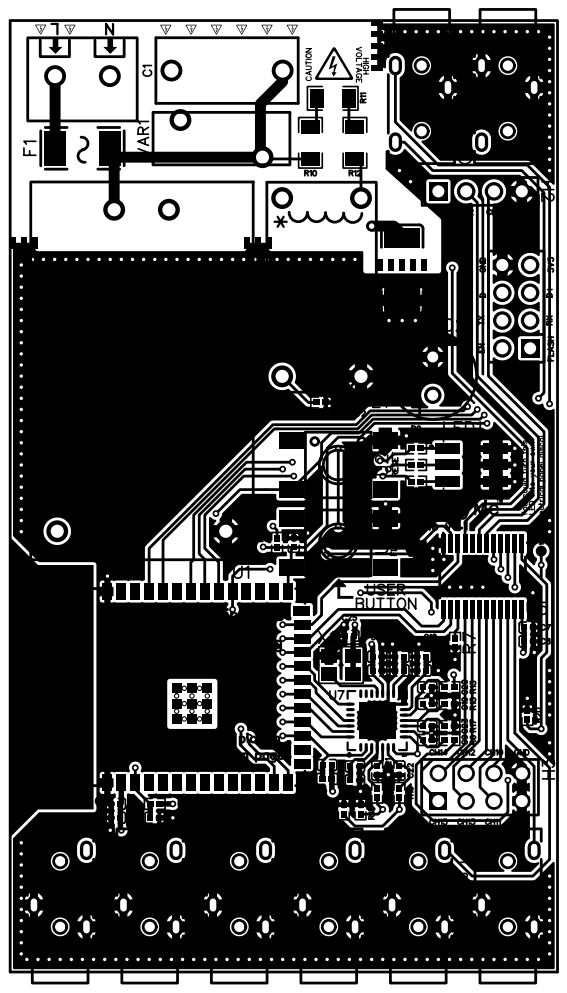
[picture p52: page 1]
