SAMIARSLAN-NKU/EnergyMe-Open-Source-Smart-Energy-Meter/(list of files, drawings)

Other design files:
hardware/pcb/backup_easy_eda/pcb_top_board_1.json
hardware/pcb/backup_easy_eda/pcb_top_board_2.json
hardware/pcb/backup_easy_eda/schematic_main_board.json
