SAMIARSLAN-NKU/EnergyMe-Open-Source-Smart-Energy-Meter/(commit log)

2026-07-04 Add files via upload
    Initial release of hardware, firmware, documentation, and validation files
    [BoardDrawing.dxf]
2026-07-04 Initial project files
    [bom_main_board.csv, bom_top_board_1.csv, bom_top_board_2.csv, partitions_esp32s3_n16r2.csv, pcb_top_board_1.json, pcb_top_board_2.json, pick_and_place_main_board.csv, pick_and_place_top_board_1.csv]
