SAMIARSLAN-NKU/EnergyMe-Open-Source-Smart-Energy-Meter/(notices)

Notices in the files:
EnergyMe-Home-main/source/include/ade7953.h:
SPDX-License-Identifier: GPL-3.0-or-later
Copyright (C) 2025 Jibril Sharafi
